BurtHarris/redoubler/images/Resistor Placement.png

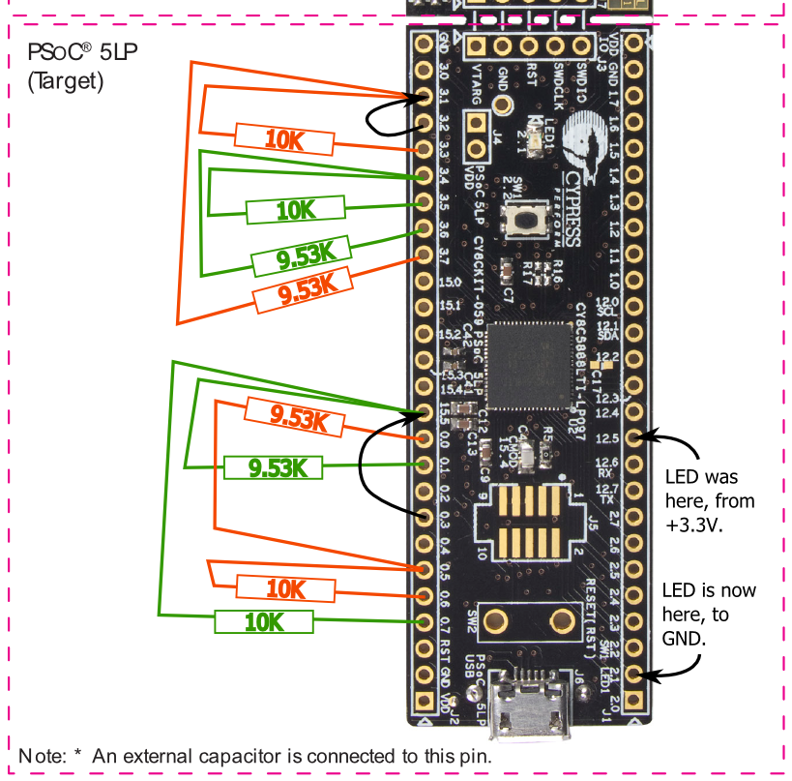
images/Resistor Placement.png
